Sundarram/Quadbot-Control-using-Leap-Motion-Sensor/QuadBot.jpg

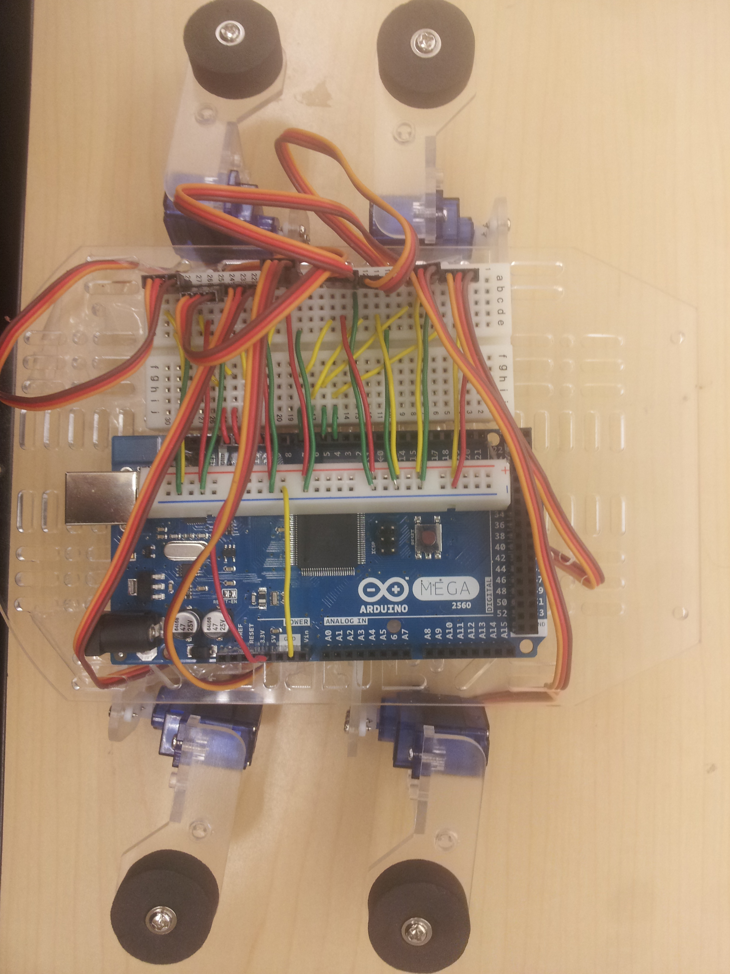
QuadBot.jpg
