Sundarram/Quadbot-Control-using-Leap-Motion-Sensor/Codes/angles.h

int displacement=30;    // Displacement angle of every step
int delay_time=5;       // Time delay between displacement of every angle

int stretch_displacement=40;
int stretch_delay_time=20;

// Angles for the QuadBot to stand up 

int stand_position[8]={ 
  180,180,180,180,      // Knee servo angles in the order of   Left Front, Right Front, Right Rear, Left Rear
  115,70,70,90};        // Hip servo angles  in the order of  Left Front, Right Front, Right Rear, Left Rear
